hakmo/rat-ratgdo/kicad_files/S2 Mini - ESP32/production/rat-ratgdo.stl

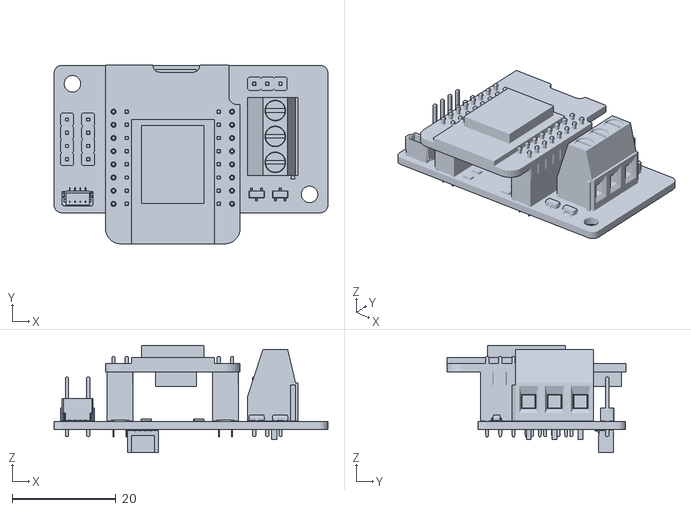
[picture p2: CAD file, 2024-11-05]
kicad_files/S2 Mini - ESP32/production/rat-ratgdo.stl
52.8 x 34.5 x 20.7
