hakmo/rat-ratgdo/kicad_files/S2 Mini - ESP32/production/case_bottom.stl

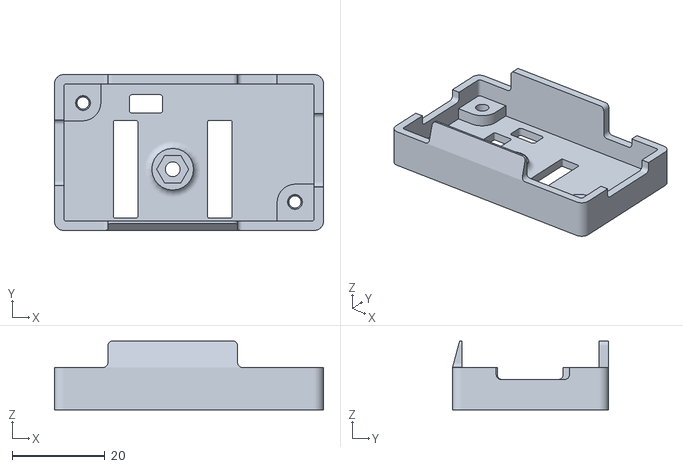
[picture p3: CAD file, 2024-11-05]
kicad_files/S2 Mini - ESP32/production/case_bottom.stl
58.0 x 33.6 x 14.9
