hakmo/rat-ratgdo/kicad_files/S2 Mini - ESP32/rat-ratgdo.kicad_pcb

## KiCad design kicad_files/S2 Mini - ESP32/rat-ratgdo.kicad_pcb (2024-11-05)

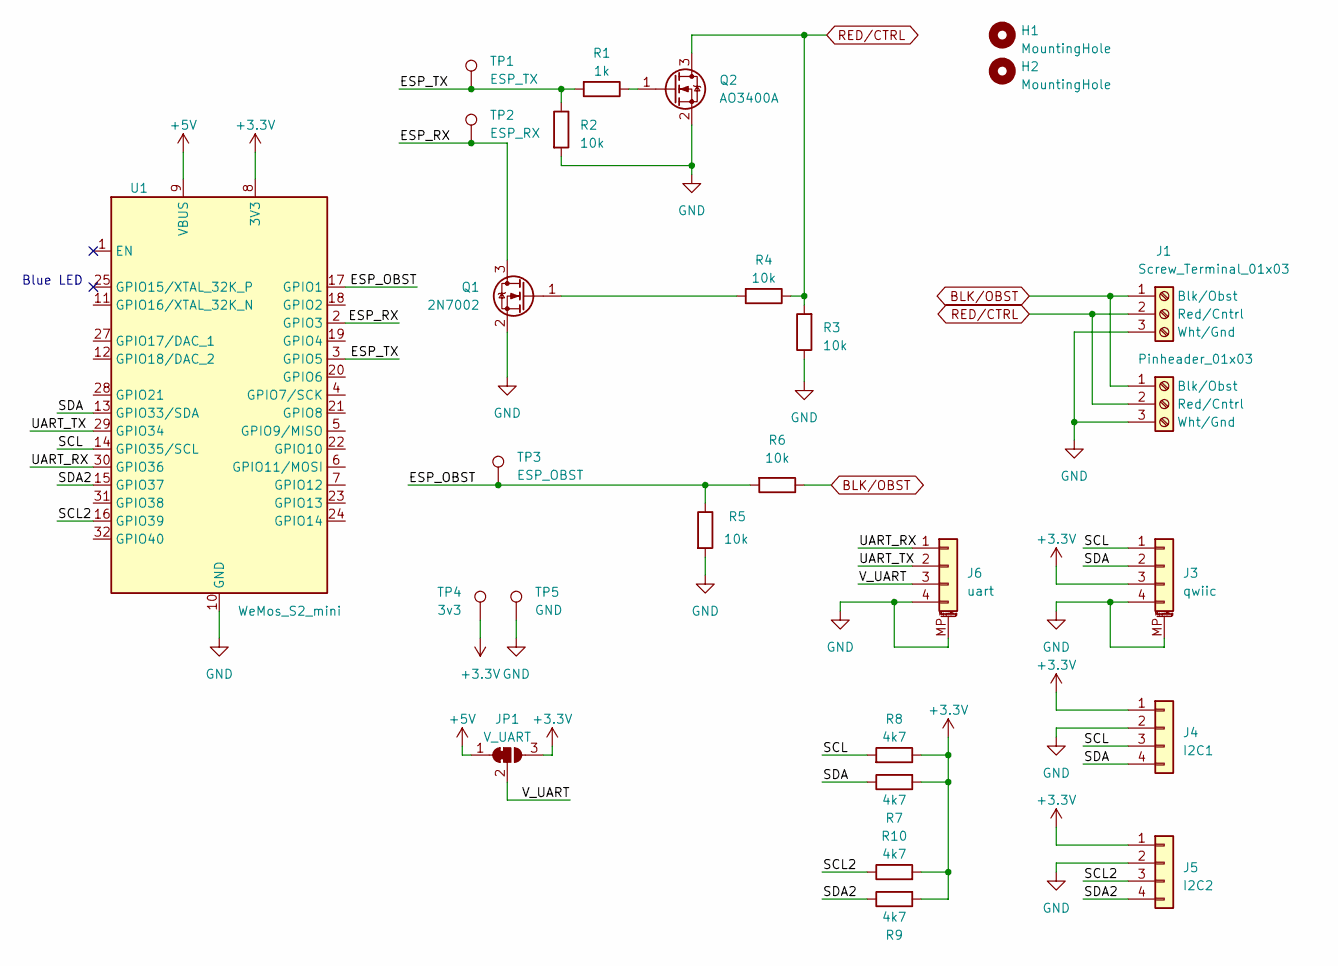
[picture p4: schematic rat-ratgdo.kicad_sch]

Parts:
H1, H2: MountingHole; MountingHole_3.2mm_M3
J1: Screw_Terminal_01x03; TerminalBlock_Phoenix_MKDS-1,5-3_1x03_P5.00mm_Horizontal
J2: Pinheader_01x03; PinHeader_1x03_P2.54mm_Vertical
J3: qwiic; JST_SH_BM04B-SRSS-TB_1x04-1MP_P1.00mm_Vertical
J4: I2C1; PinHeader_1x04_P2.54mm_Vertical
J5: I2C2; PinHeader_1x04_P2.54mm_Vertical
J6: uart; JST_SH_BM04B-SRSS-TB_1x04-1MP_P1.00mm_Vertical
JP1: V_UART; SolderJumper-3_P1.3mm_Bridged12_RoundedPad1.0x1.5mm_NumberL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
Q1: 2N7002; SOT-23_Handsoldering
Q2: AO3400A; SOT-23_Handsoldering
R1: 1k; R_0805_2012Metric_Pad1.20x1.40mm_HandSolder
R2, R3, R4, R5, R6: 10k; R_0805_2012Metric_Pad1.20x1.40mm_HandSolder
R7, R8, R9, R10: 4k7; R_0805_2012Metric_Pad1.20x1.40mm_HandSolder
TP1: ESP_TX; TestPoint_Pad_D1.5mm
TP2: ESP_RX; TestPoint_Pad_D1.5mm
TP3: ESP_OBST; TestPoint_Pad_D1.5mm
TP4: 3v3; TestPoint_Pad_D1.5mm
TP5: GND; TestPoint_Pad_D1.5mm
U1: WeMos_S2_mini; WEMOS_S2_mini

Connections:
+3.3V: J3.3, J4.1, J5.1, JP1.3 (B), R7.2, R8.1, R9.2, R10.2, TP4.1, U1.8 (3V3)
+5V: JP1.1 (A), U1.9 (VBUS)
/ESP_OBST: R5.1, R6.2, TP3.1, U1.17 (GPIO1)
/ESP_RX: Q1.3 (D), TP2.1, U1.2 (GPIO3)
/ESP_TX: R1.2, R2.1, TP1.1, U1.3 (GPIO5)
/SCL: J3.1, J4.3, R8.2, U1.14 (GPIO35/SCL)
/SCL2: J5.3, R10.1, U1.16 (GPIO39)
/SDA: J3.2, J4.4, R7.1, U1.13 (GPIO33/SDA)
/SDA2: J5.4, R9.1, U1.15 (GPIO37)
/UART_RX: J6.1, U1.30 (GPIO36)
/UART_TX: J6.2, U1.29 (GPIO34)
/V_UART: J6.3, JP1.2 (C)
BLK/OBST: J1.1 (Blk/Obst), J2.1 (Blk/Obst), R6.1
GND: J1.3 (Wht/Gnd), J2.3 (Wht/Gnd), J3.4, J3.MP (MountPin), J4.2, J5.2, J6.4, J6.MP (MountPin), Q1.2 (S), Q2.2 (S), R2.2, R3.1, R5.2, TP5.1, U1.10 (GND), U1.26 (GND)
unnamed: Q1.1 (G), R4.2
unnamed: Q2.1 (G), R1.1
RED/CTRL: J1.2 (Red/Cntrl), J2.2 (Red/Cntrl), Q2.3 (D), R3.2, R4.1

Notes on the sheet:
Blue LED

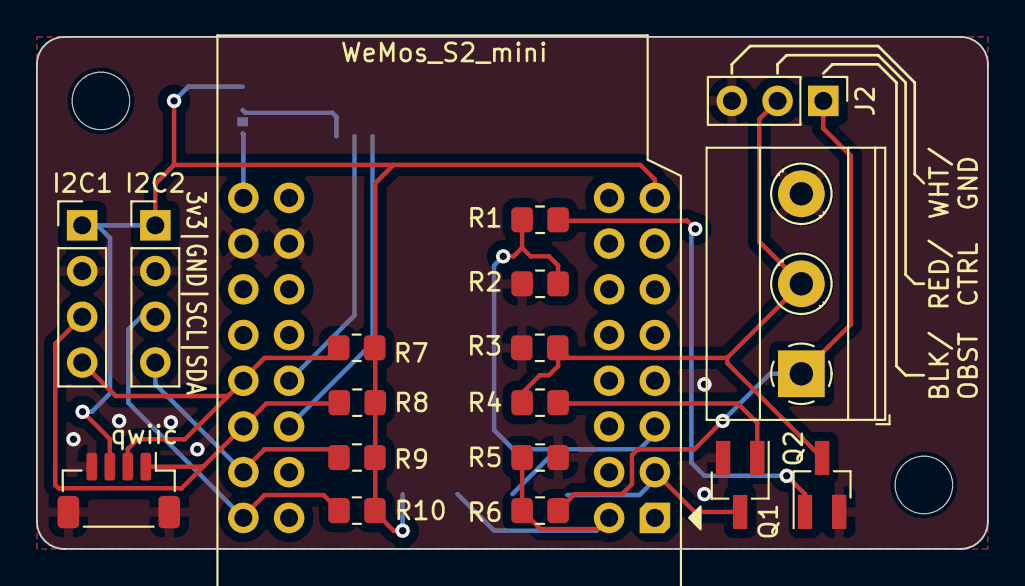
[picture p5: board rat-ratgdo.kicad_pcb from above]

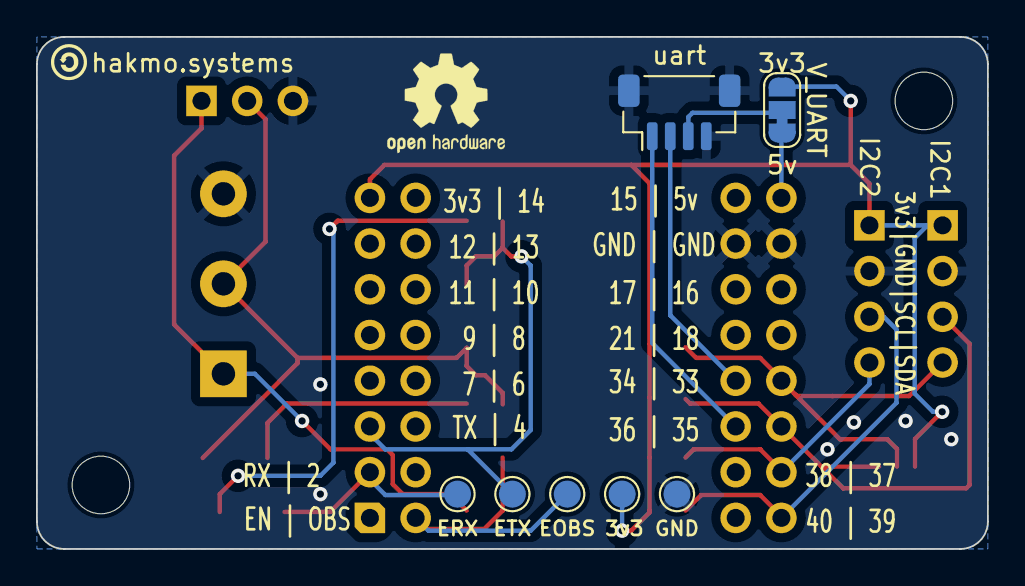
[picture p6: board rat-ratgdo.kicad_pcb from below]

Board: 2 copper layers, 52.8 x 28.4 mm, 27 parts (7 on the bottom side), 17 nets.
